tabyrocket/fire-extinguishing-robot/figures/fuzzy_membership_runtime.png

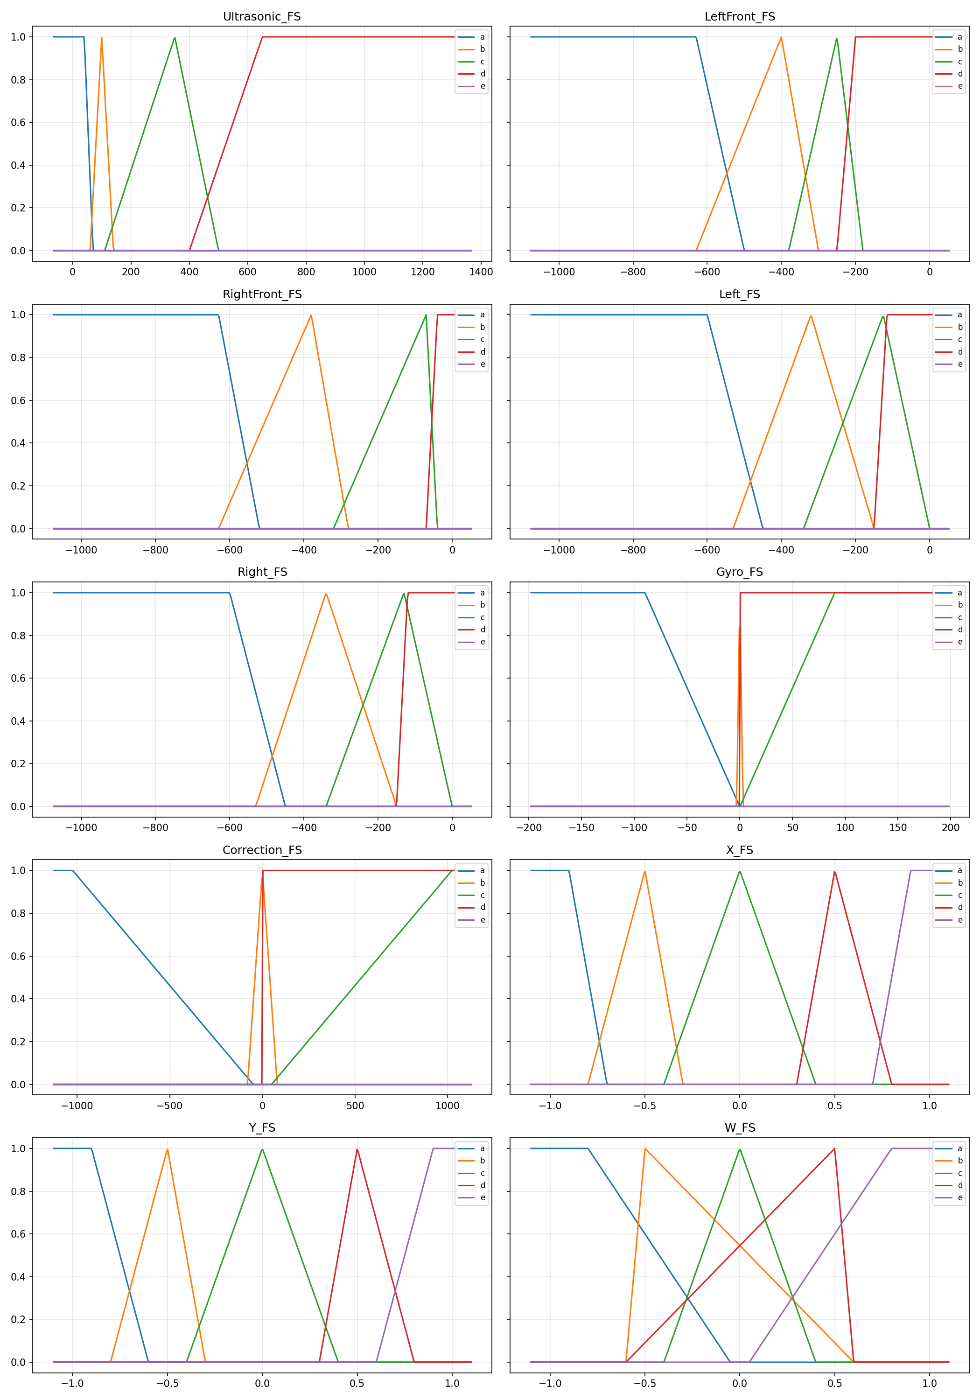
figures/fuzzy_membership_runtime.png
