tabyrocket/fire-extinguishing-robot/(commit log)

2026-08-14 Project restructure and upload
    Add the full Arduino/C++ project for the autonomous fire-extinguishing robot, including modular actuator and sensor drivers, robot control logic, fuzzy inference engine, and a multi-state FSM for search, navigation, extinguishing, and recovery behavior. Also add project documentation, media assets, and a plotting utility for fuzzy membership functions.
2026-08-14 Fix formatting in inverse kinematics section
